raghavsub/ukele-led/README.md

ukule-led
=========

Raghav's and Jeff's 4760 Final Project
