raghavsub/ukele-led/test/ras578_yt336/ras578_yt336/webpage_files/placeholder.jpg

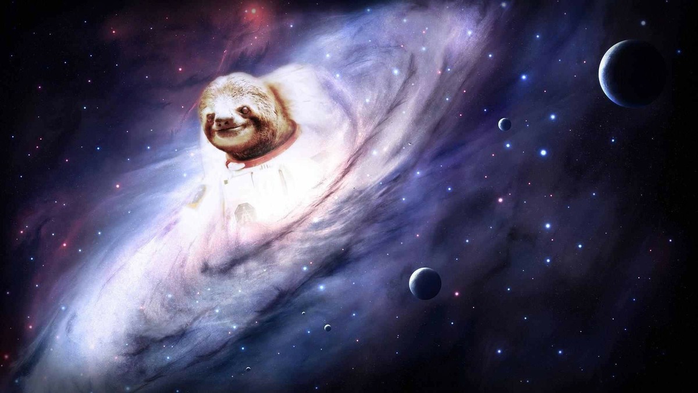
test/ras578_yt336/ras578_yt336/webpage_files/placeholder.jpg
