raghavsub/ukele-led/chord_lookup_table.h

#ifndef _CHORD_LOOKUP_TABLE
#define _CHORD_LOOKUP_TABLE

RGB_t lookup_table[37][16] = {

{{0, 0, 0}, {0, 0, 0}, {0, 0, 0}, {0, 0, 0}, {0, 0, 0}, {0, 0, 0}, {0, 0, 0}, {0, 0, 0}, {0, 0, 0}, {0, 0, 0}, {0, 0, 0}, {0, 0, 0}, {0, 0, 0}, {0, 0, 0}, {0, 0, 0}, {0, 0, 0}},
{{0, 0, 0}, {0, INTENS, 0}, {0, 0, 0}, {0, 0, 0}, {0, 0, 0}, {0, 0, 0}, {0, 0, 0}, {0, INTENS, 0}, {0, 0, 0}, {0, 0, 0}, {0, 0, 0}, {0, 0, 0}, {0, 0, 0}, {0, 0, 0}, {0, 0, 0}, {0, 0, 0}},
{{0, 0, 0}, {0, 0, 0}, {0, 0, 0}, {0, 0, 0}, {0, 0, 0}, {0, 0, 0}, {0, 0, 0}, {INTENS, 0, 0}, {0, 0, 0}, {0, 0, 0}, {0, 0, 0}, {0, 0, 0}, {0, 0, 0}, {0, 0, 0}, {0, 0, 0}, {0, 0, 0}},
{{0, 0, 0}, {0, 0, INTENS}, {0, 0, 0}, {0, 0, 0}, {0, 0, 0}, {0, 0, 0}, {0, 0, 0}, {0, 0, 0}, {0, 0, 0}, {0, 0, 0}, {0, 0, 0}, {0, 0, 0}, {0, 0, 0}, {0, 0, 0}, {0, 0, 0}, {0, 0, 0}},
{{0, 0, 0}, {0, 0, 0}, {0, INTENS, 0}, {0, INTENS, 0}, {0, 0, 0}, {0, 0, 0}, {0, INTENS, 0}, {0, 0, 0}, {0, INTENS, 0}, {0, 0, 0}, {0, 0, 0}, {0, 0, 0}, {0, 0, 0}, {0, 0, 0}, {0, 0, 0}, {0, 0, 0}},
{{0, 0, 0}, {INTENS, 0, 0}, {INTENS, 0, 0}, {INTENS, 0, 0}, {0, 0, 0}, {0, 0, 0}, {0, 0, 0}, {0, 0, 0}, {INTENS, 0, 0}, {0, 0, 0}, {0, 0, 0}, {0, 0, 0}, {0, 0, 0}, {0, 0, 0}, {0, 0, 0}, {0, 0, 0}},
{{0, 0, INTENS}, {0, 0, 0}, {0, 0, INTENS}, {0, 0, INTENS}, {0, 0, 0}, {0, 0, 0}, {0, 0, INTENS}, {0, 0, 0}, {0, 0, 0}, {0, 0, 0}, {0, 0, 0}, {0, 0, 0}, {0, 0, 0}, {0, 0, 0}, {0, 0, 0}, {0, 0, 0}},
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
{{0, 0, INTENS}, {0, 0, 0}, {0, 0, 0}, {0, 0, 0}, {0, 0, 0}, {0, 0, INTENS}, {0, 0, 0}, {0, 0, 0}, {0, 0, 0}, {0, 0, INTENS}, {0, 0, 0}, {0, 0, INTENS}, {0, 0, 0}, {0, 0, 0}, {0, 0, 0}, {0, 0, 0}}

};

#endif
