raghavsub/ukele-led/test/ras578_yt336/ras578_yt336/webpage_files/code/trtSettings.h

//trtSettings.h
// include before trtkernel

#define MAXNBRTASKS 4
#define MAXNBRSEMAPHORES 6 // 3 sem (1-3) are needed for uart
#define MAXNBRMUTEX 1

#define PRESCALER 1024 // the actual value for timer1 prescalar
#define PRESCALEBITS 5 // the bits to be set in TCCR1b 

#define F_CPU 16000000UL // clock frequency in Hz
#define TICKSPERSECOND F_CPU / PRESCALER

/* UART baud rate */
#define UART_BAUD  9600
