raghavsub/ukele-led/test/ras578_yt336/ras578_yt336/webpage_files/code/chord_map.py

chord_map = \
{
 'X': 0, 
 'A': 1, 'Am': 2, 'A7': 3,
 'A#': 4, 'A#m': 5, 'A#7': 6,
 'Bb': 4, 'Bbm': 5, 'Bb7': 6,
 'B': 7, 'Bm': 8, 'B7': 9,
 'C': 10, 'Cm': 11, 'C7': 12,
 'C#': 13, 'C#m': 14, 'C#7': 15,
 'Db': 13, 'Dbm': 14, 'Db7': 15,
 'D': 16, 'Dm': 17, 'D7': 18,
 'D#': 19, 'D#m': 20, 'D#7': 21,
 'Eb': 19, 'Ebm': 20, 'Eb7': 21,
 'E': 22, 'Em': 23, 'E7': 24,
 'F': 25, 'Fm': 26, 'F7': 27,
 'F#': 28, 'F#m': 29, 'F#7': 30,
 'Gb': 28, 'Gbm': 29, 'Gb7': 30,
 'G': 31, 'Gm': 32, 'G7': 33,
 'G#': 34, 'G#m': 35, 'G#7': 36,
 'Ab': 34, 'Abm': 35, 'Ab7': 36
}
